judasgutenberg/Hotspot-Watchdog/(commit log)

2022-04-24 now just uses the BME680 environment sensor
2022-04-26 less chicken-little with the moxee reboots
    [watchdog.ino]
2022-05-02 skew the upload time if there is an upload issue
    [watchdog.ino]
